JoshuaZhang7567/riscv-core-pipelined/rtl/core/regfile.sv

// 32x32 register file: 2 async reads, 1 sync write, x0 hardwired to zero.

import riscv_pkg::*;

module regfile (
    input  logic                  clk,
    input  logic                  reg_write,
    input  logic [REG_ADDR_W-1:0] rd,
    input  logic [XLEN-1:0]       write_data,
    input  logic [REG_ADDR_W-1:0] rs1,
    output logic [XLEN-1:0]       read_data1,
    input  logic [REG_ADDR_W-1:0] rs2,
    output logic [XLEN-1:0]       read_data2
);

  logic [XLEN-1:0] rf [NUM_REGS-1:0];

  // Synchronous write (x0 stays zero)
  always_ff @(posedge clk) begin
    if (reg_write && rd != '0)
      rf[rd] <= write_data;
  end

  // Asynchronous reads with write-first forwarding
  // If the register being read is simultaneously being written (WB→ID),
  // forward the write data directly to avoid a stale read.
  assign read_data1 = (rs1 == '0)                          ? '0 :
                      (rs1 == rd && reg_write)              ? write_data :
                                                             rf[rs1];
  assign read_data2 = (rs2 == '0)                          ? '0 :
                      (rs2 == rd && reg_write)              ? write_data :
                                                             rf[rs2];

endmodule
