JoshuaZhang7567/riscv-core-pipelined/rtl/core/immgen.sv

import riscv_pkg::*;

module immgen(input  logic [31:7]  instr,
              input  imm_src_t     immsrc,  
              output logic [XLEN-1:0] immext);

  always_comb
    case(immsrc)
      IMM_I:   immext = {{20{instr[31]}}, instr[31:20]};
      IMM_S:   immext = {{20{instr[31]}}, instr[31:25], instr[11:7]};
      IMM_B:   immext = {{19{instr[31]}}, instr[31], instr[7],
                          instr[30:25], instr[11:8], 1'b0};
      IMM_J:   immext = {{12{instr[31]}}, instr[19:12],
                          instr[20], instr[30:21], 1'b0};
      IMM_U:   immext = {instr[31:12], 12'b0};
      default: immext = {XLEN{1'bx}};
    endcase

endmodule
