JoshuaZhang7567/riscv-core-pipelined/(commit log)

2026-07-05 refactor: transition to 5-stage pipelined architecture with hazard unit, forwarding, and stall logic
    [control.sv, pc.sv, regfile.sv, riscv_top.sv]
2026-09-27 Add DE1-SoC FPGA synthesis support
    - Memory-mapped I/O in riscv_top: io_out at 0x8000_0000, io_in at
    0x8000_0004, so the core has observable outputs and is not optimized away
    - IF/ID and ID/EX registers use synchronous reset; mixing the synchronous
    flush into an async-reset condition fails in Quartus (error 10200)
    - dmem rewritten with byte enables in the form Quartus infers as RAM
    - de1soc_top board wrapper: reset and switch synchronizers, LEDR and
    HEX0-5 display of io_out, hex7seg decoder
    - Quartus project (fpga/de1soc): device, sources, verified pin map, SDC
    - LED counter demo program (tools/gen_led_counter.py) and a board-level
    testbench; make fpga-sim / fpga / fpga-program / fpg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
    [de1soc_top.sv, dmem.sv, hex7seg.sv, riscv_top.sv, tb_de1soc_top.sv, tb_riscv_universal.sv]
2026-09-28 Use the Quartus Lite GUI flow instead of Make targets for the FPGA build
